miata-bot/daveecu2/pnps/Mazda/miata_89-93/miata_89-93.kicad_pcb

## KiCad design pnps/Mazda/miata_89-93/miata_89-93.kicad_pcb (2021-05-07)

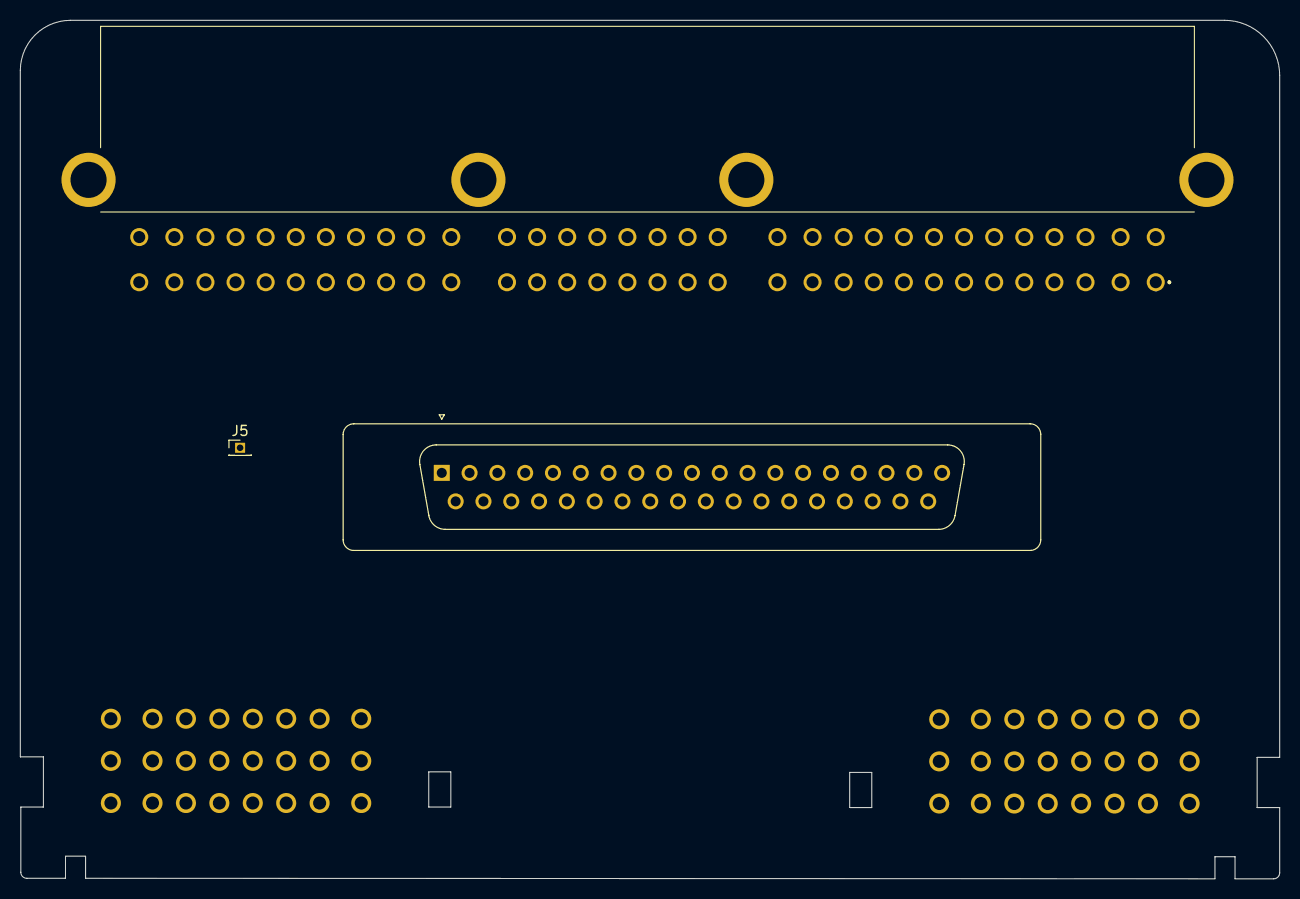
[picture p2: board miata_89-93.kicad_pcb from above]

Board: 2 copper layers, 125.5 x 85.5 mm, 5 parts (0 on the bottom side), 24 nets.

Parts:
J1: 174518-7
J2: Conn_01x37; DSUB-37_Male_Vertical_P2.77x2.84mm
J3: CONN_BLACK; Delphi_Sicma_24_Black
J4: CONN_GRAY; Delphi_Sicma_24_Grey
J5: 2ND TRIGGER; PinHeader_1x01_P1.27mm_Vertical

Connections:
GND: J1.MH1, J1.MH2, J1.MH3, J1.MH4, J3.A1, J3.A3, J3.A4, J3.A5, J3.B1, J3.B2, J3.B3, J3.B4, J4.C1, J4.C2
MIATA_1B: J1.16, J2.28
MIATA_1E: J1.56, J4.B4
MIATA_1G: J1.55, J3.C1
MIATA_1H: J1.63, J3.C3
MIATA_1N: J1.52, J1.60, J2.26, J3.A7
MIATA_1Q: J1.50, J4.A1
MIATA_1R: J1.58, J4.C4
MIATA_1V: J1.12, J4.A2
MIATA_2A: J1.8, J2.8, J2.9
MIATA_2C: J1.7, J2.1
MIATA_2D: J1.9, J2.2
MIATA_2E: J1.24, J2.24, J4.A8
MIATA_2G: J1.23, J4.A7, J5.1
MIATA_2I: J1.22, J4.C5
MIATA_2K: J1.21, J4.B8
MIATA_2L: J1.29, J2.22, J4.A3
MIATA_2N: J1.28, J2.23
MIATA_2O: J1.19, J2.37, J4.C3
MIATA_2P: J1.27, J2.20, J4.A4
MIATA_2Q: J1.18, J2.21, J4.A5
MIATA_2U: J1.3, J3.C7
MIATA_2V: J1.6, J3.C5
MIATA_2W: J1.2, J4.B7
