miata-bot/daveecu2/daveecu2.kicad_pcb

## KiCad design daveecu2.kicad_pcb (2021-05-07)

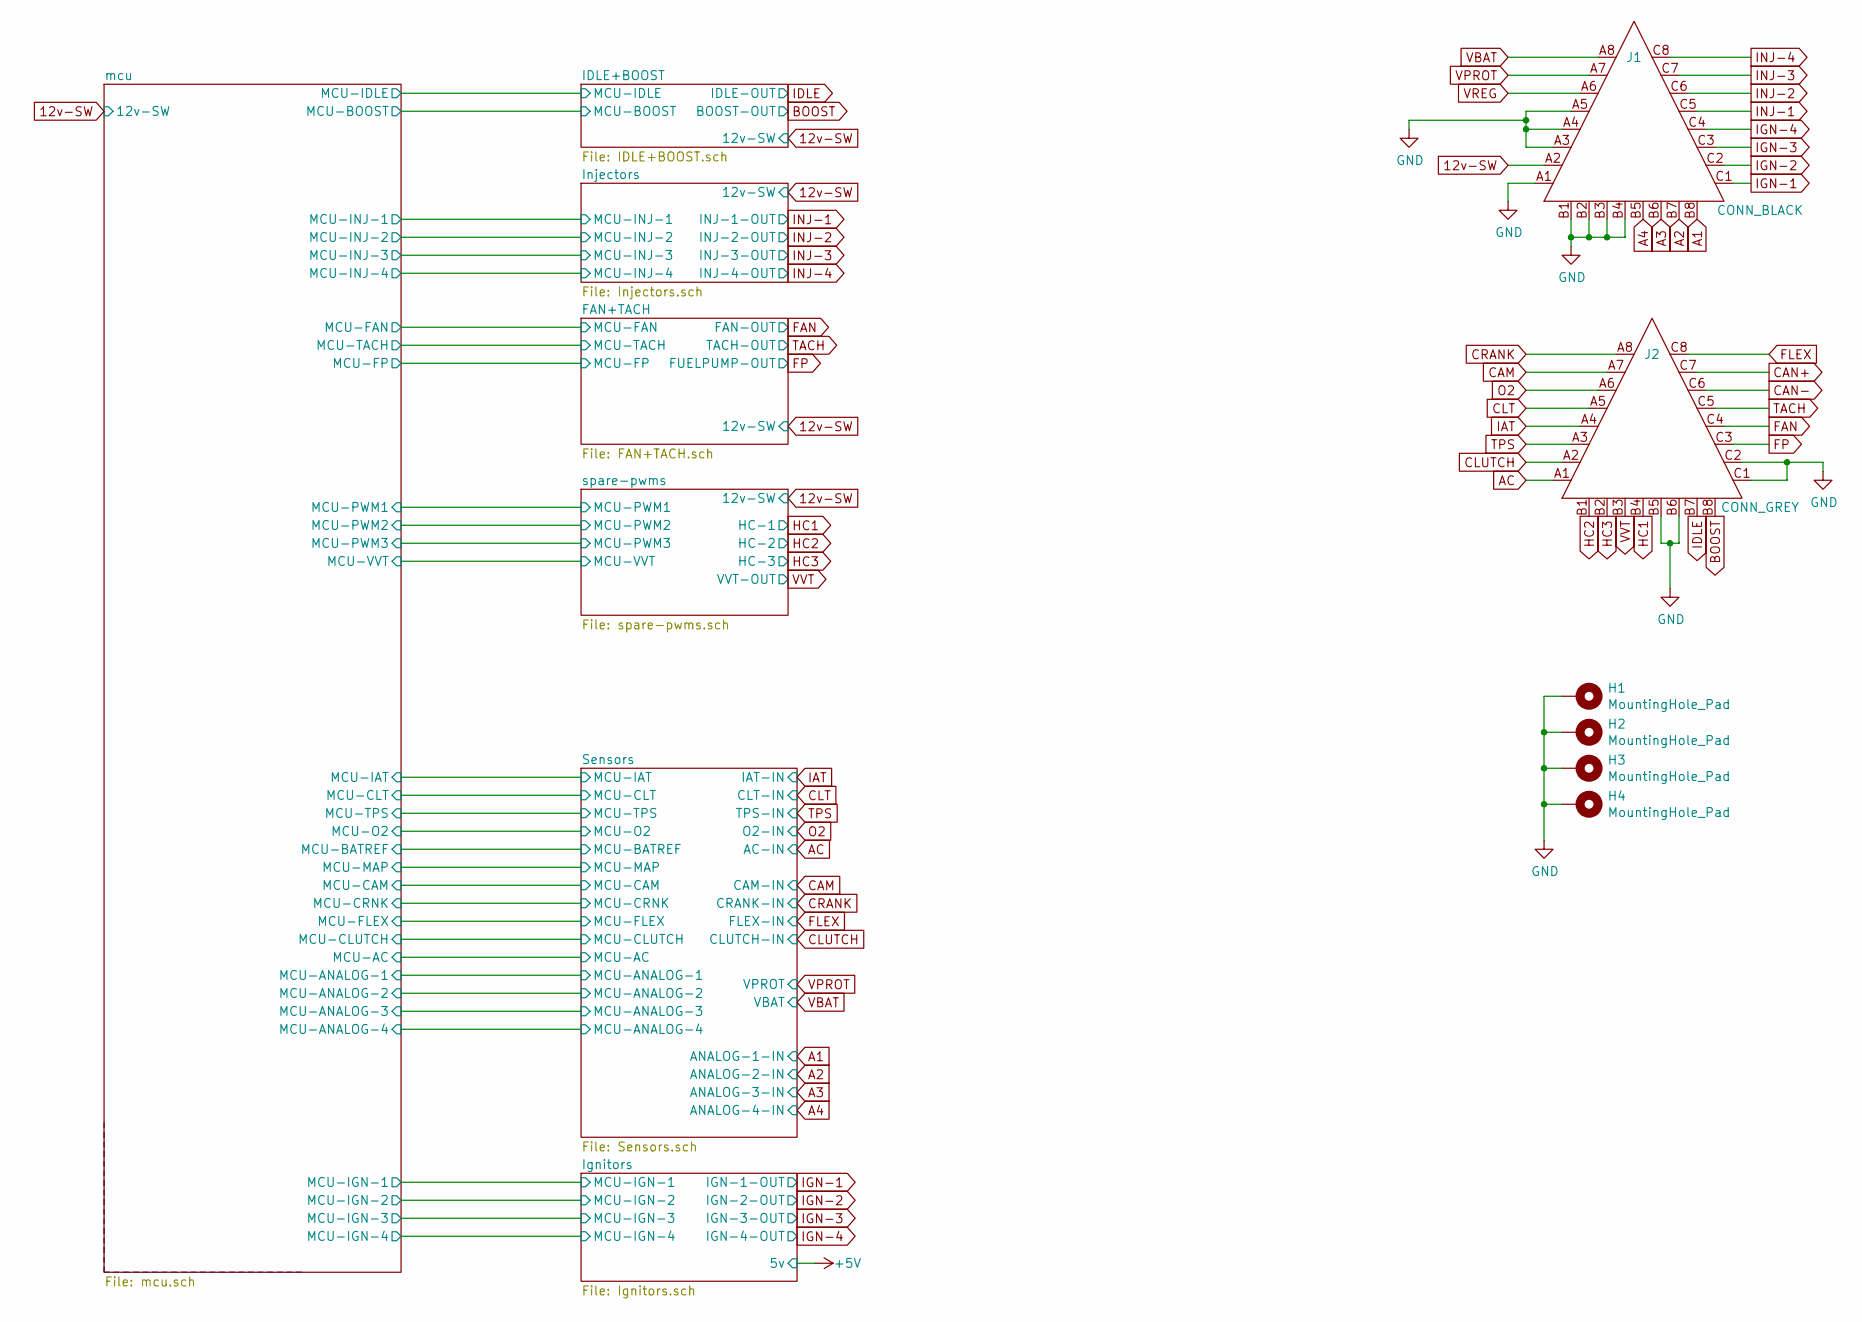
[picture p3: schematic daveecu2.sch]

Parts:
H1, H2, H3, H4: MountingHole_Pad; MountingHole_4.3mm_M4_Pad_Via
J1: CONN_BLACK; Delphi_Sicma_24_Black
J2: CONN_GREY; Delphi_Sicma_24_Grey

Connections:
12v-SW: J1.A2; also elsewhere on the board
A1: J1.B8; also elsewhere on the board
A2: J1.B7; also elsewhere on the board
A3: J1.B6; also elsewhere on the board
A4: J1.B5; also elsewhere on the board
AC: J2.A1; also elsewhere on the board
ADC-CLAMP-7: J2.C8; also elsewhere on the board
BOOST: J2.B8; also elsewhere on the board
CAM: J2.A7; also elsewhere on the board
CAN+: J2.C7; also elsewhere on the board
CAN-: J2.C6; also elsewhere on the board
CLT: J2.A5; also elsewhere on the board
CLUTCH: J2.A2; also elsewhere on the board
CRANK: J2.A8; also elsewhere on the board
FAN: J2.C4; also elsewhere on the board
FP: J2.C3; also elsewhere on the board
GND: H1.1, H2.1, H3.1, H4.1, J1.A1, J1.A3, J1.A4, J1.A5, J1.B1, J1.B2, J1.B3, J1.B4, J2.B5, J2.B6, J2.C1, J2.C2; also elsewhere on the board
HC1: J2.B4; also elsewhere on the board
HC2: J2.B1; also elsewhere on the board
HC3: J2.B2; also elsewhere on the board
IAT: J2.A4; also elsewhere on the board
IDLE: J2.B7; also elsewhere on the board
IGN-1: J1.C1; also elsewhere on the board
IGN-2: J1.C2; also elsewhere on the board
IGN-3: J1.C3; also elsewhere on the board
IGN-4: J1.C4; also elsewhere on the board
INJ-1: J1.C5; also elsewhere on the board
INJ-2: J1.C6; also elsewhere on the board
INJ-3: J1.C7; also elsewhere on the board
INJ-4: J1.C8; also elsewhere on the board
O2: J2.A6; also elsewhere on the board
TACH: J2.C5; also elsewhere on the board
TPS: J2.A3; also elsewhere on the board
VBAT: J1.A8; also elsewhere on the board
VPROT: J1.A7; also elsewhere on the board
VREG: J1.A6; also elsewhere on the board
VVT: J2.B3; also elsewhere on the board

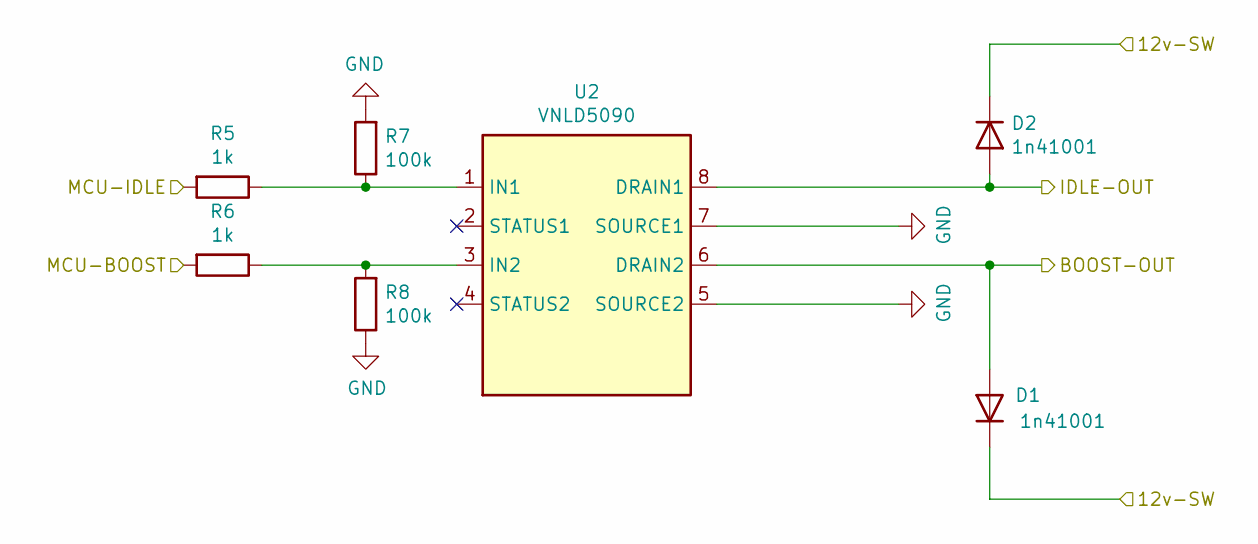
[picture p4: schematic IDLE+BOOST.sch, DaveECU2]

Parts:
D1, D2: 1n41001; D_SOD-123; LCSC_PN C162732
R5, R6: 1k; R_0603_1608Metric_Pad0.98x0.95mm_HandSolder; DIGIKEY 311-1.00KCRCT-ND
R7, R8: 100k; R_0603_1608Metric_Pad0.98x0.95mm_HandSolder; DIGIKEY 311-100KCRCT-ND
U2: VNLD5090; SOIC-8_3.9x4.9mm_P1.27mm

Connections:
12v-SW: D1.1 (K), D2.1 (K); also elsewhere on the board
/IDLE+BOOST/MCU-BOOST: R6.2; also elsewhere on the board
/IDLE+BOOST/MCU-IDLE: R5.2; also elsewhere on the board
BOOST: D1.2 (A), U2.6 (DRAIN2); also elsewhere on the board
GND: R7.2, R8.1, U2.5 (SOURCE2), U2.7 (SOURCE1); also elsewhere on the board
IDLE: D2.2 (A), U2.8 (DRAIN1); also elsewhere on the board
unnamed: R5.1, R7.1, U2.1 (IN1)
unnamed: R6.1, R8.2, U2.3 (IN2)

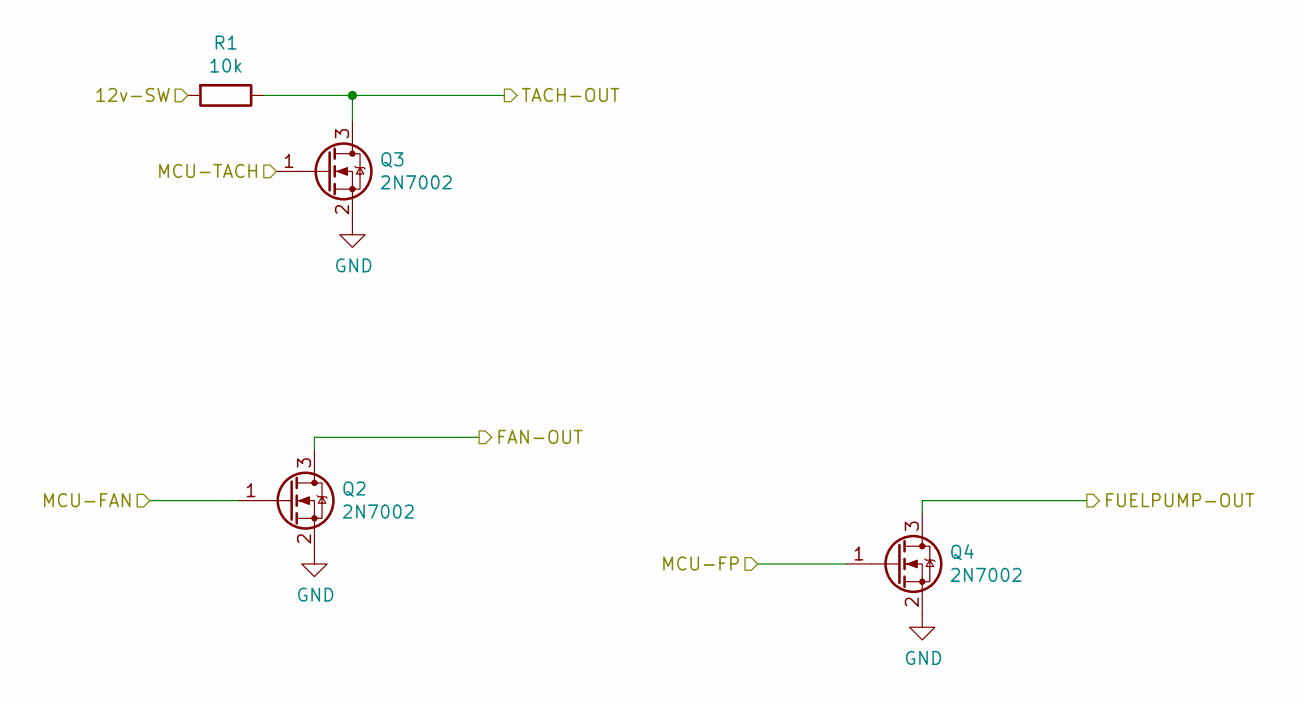
[picture p5: schematic FAN+TACH.sch, DaveECU2]

Parts:
Q2, Q3, Q4: 2N7002; SOT-23
R1: 10k; R_0603_1608Metric_Pad0.98x0.95mm_HandSolder; DIGIKEY 311-1.00KCRCT-ND

Connections:
12v-SW: R1.2; also elsewhere on the board
/FAN+TACH/MCU-FAN: Q2.1 (G); also elsewhere on the board
/FAN+TACH/MCU-FP: Q4.1 (G); also elsewhere on the board
/FAN+TACH/MCU-TACH: Q3.1 (G); also elsewhere on the board
FAN: Q2.3 (D); also elsewhere on the board
FP: Q4.3 (D); also elsewhere on the board
GND: Q2.2 (S), Q3.2 (S), Q4.2 (S); also elsewhere on the board
TACH: Q3.3 (D), R1.1; also elsewhere on the board

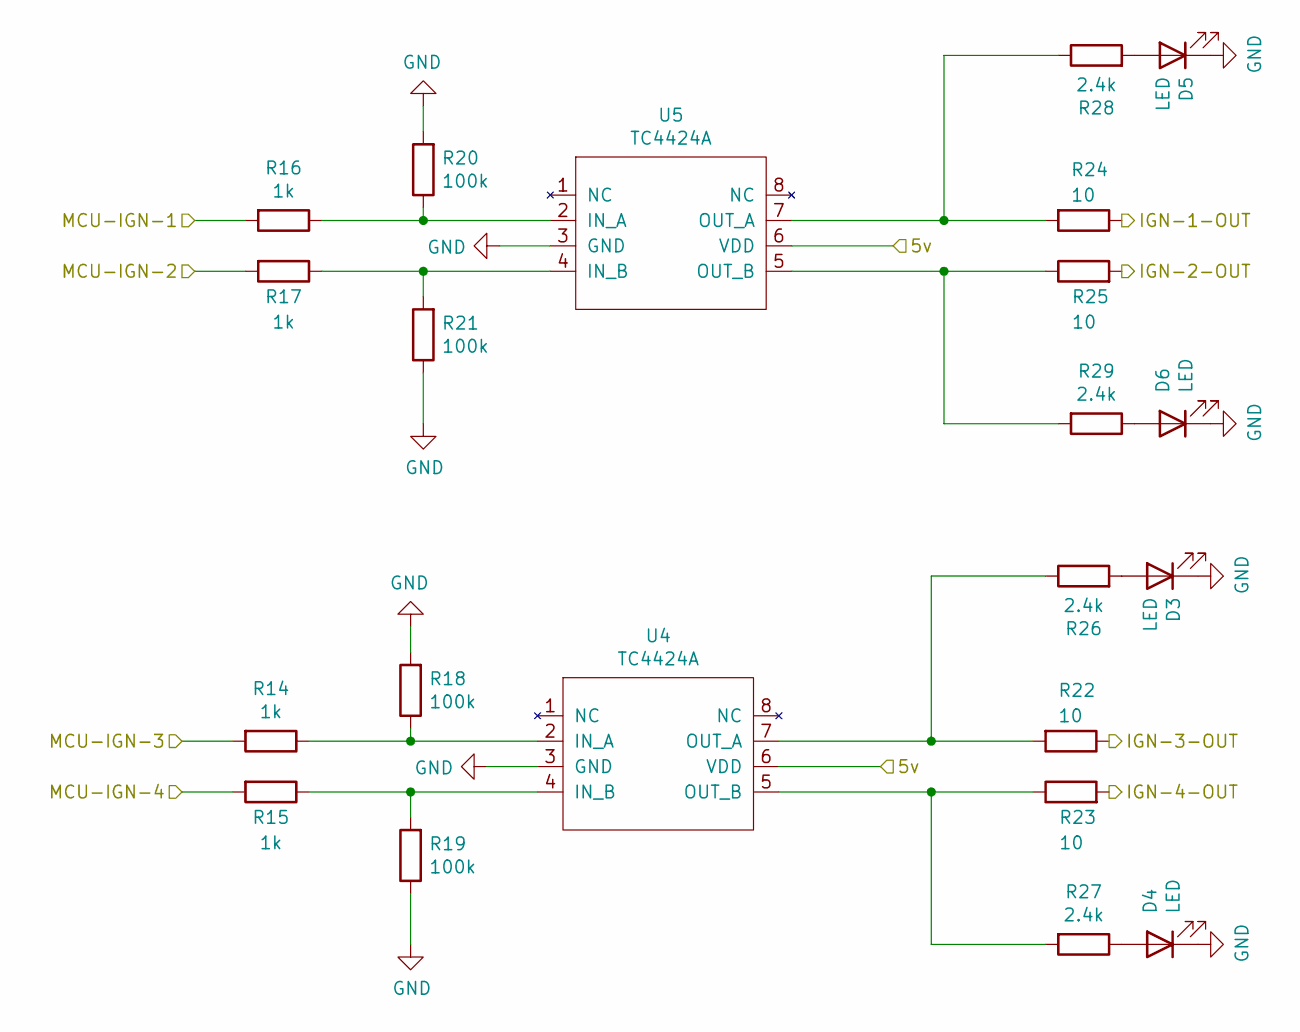
[picture p6: schematic Ignitors.sch, DaveECU2]

Parts:
D3, D4, D5, D6: LED; LED_0603_1608Metric_Pad1.05x0.95mm_HandSolder
R14, R15, R16, R17: 1k; R_0603_1608Metric_Pad0.98x0.95mm_HandSolder; DIGIKEY 311-1.00KCRCT-ND
R18, R19, R20, R21: 100k; R_0603_1608Metric_Pad0.98x0.95mm_HandSolder; DIGIKEY 311-100KCRCT-ND
R22, R23, R24, R25: 10; R_0603_1608Metric_Pad0.98x0.95mm_HandSolder; DIGIKEY 311-10.0CRCT-ND
R26, R27, R28, R29: 2.4k; R_0603_1608Metric_Pad0.98x0.95mm_HandSolder; DIGIKEY 311-2.40KCRCT-ND
U4, U5: TC4424A; SOIC-8_3.9x4.9mm_P1.27mm; DIGIKEY TC4424AVOA-ND

Connections:
/Ignitors/MCU-IGN-1: R16.2; also elsewhere on the board
/Ignitors/MCU-IGN-2: R17.2; also elsewhere on the board
/Ignitors/MCU-IGN-3: R14.2; also elsewhere on the board
/Ignitors/MCU-IGN-4: R15.2; also elsewhere on the board
GND: D3.1 (K), D4.1 (K), D5.1 (K), D6.1 (K), R18.2, R19.1, R20.2, R21.1, U4.3 (GND), U5.3 (GND); also elsewhere on the board
IGN-1: R24.1; also elsewhere on the board
IGN-2: R25.2; also elsewhere on the board
IGN-3: R22.1; also elsewhere on the board
IGN-4: R23.2; also elsewhere on the board
unnamed: D3.2 (A), R26.2
unnamed: D4.2 (A), R27.1
unnamed: D5.2 (A), R28.2
unnamed: D6.2 (A), R29.1
unnamed: R14.1, R18.1, U4.2 (IN_A)
unnamed: R15.1, R19.2, U4.4 (IN_B)
unnamed: R16.1, R20.1, U5.2 (IN_A)
unnamed: R17.1, R21.2, U5.4 (IN_B)
unnamed: R22.2, R26.1, U4.7 (OUT_A)
unnamed: R23.1, R27.2, U4.5 (OUT_B)
unnamed: R24.2, R28.1, U5.7 (OUT_A)
unnamed: R25.1, R29.2, U5.5 (OUT_B)
VPROT: U4.6 (VDD), U5.6 (VDD); also elsewhere on the board

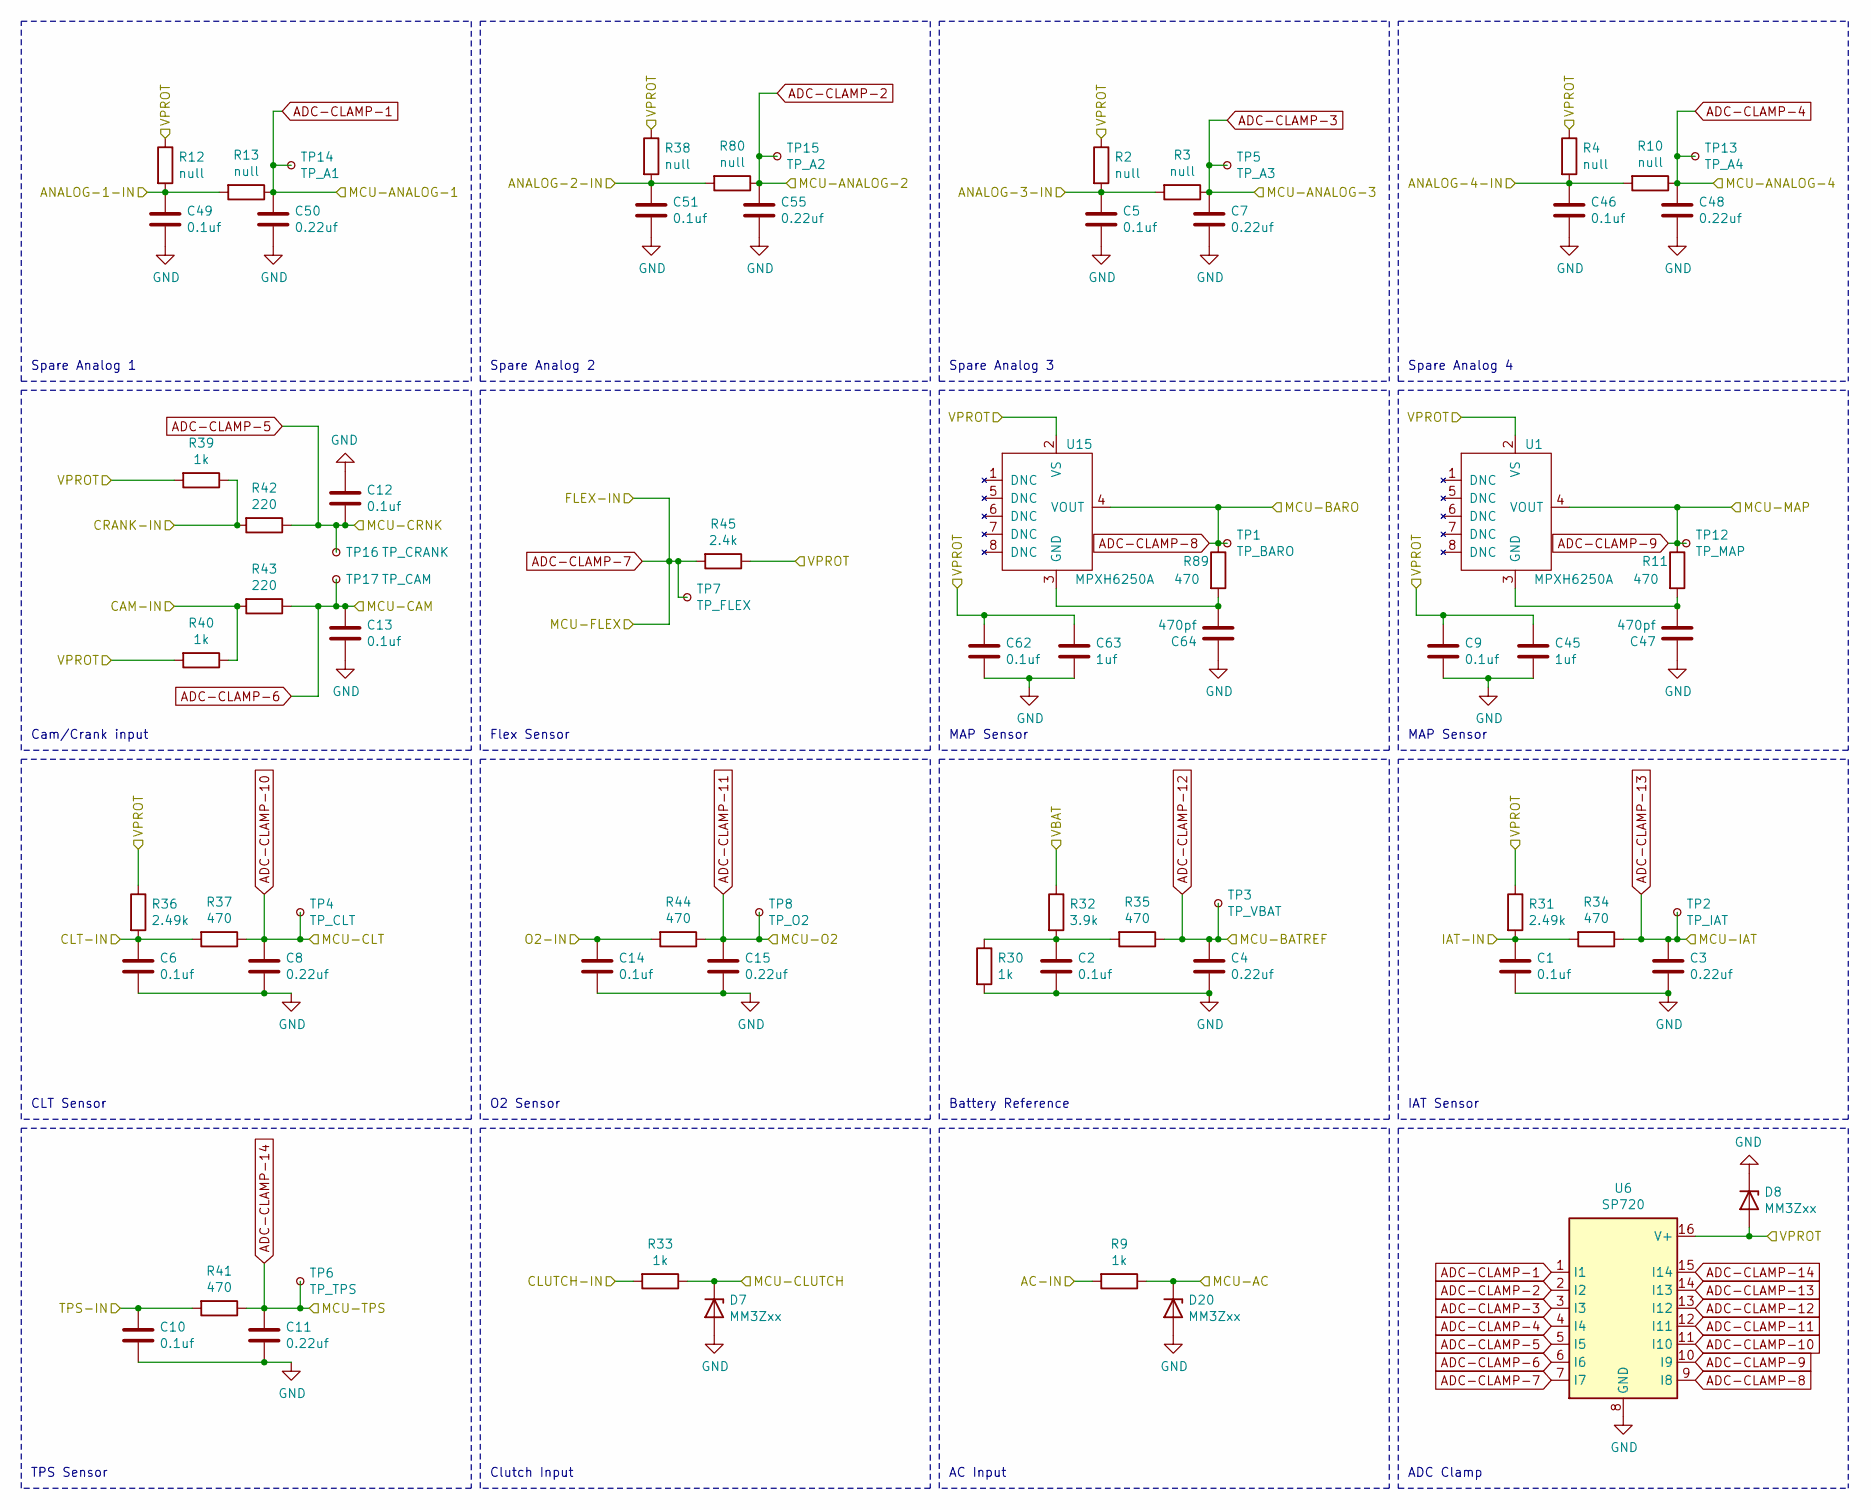
[picture p7: schematic Sensors.sch, DaveECU2]

Parts:
C1, C2, C5, C6, C9, C10, C12, C13, C14, C46, C49, C51, C62: 0.1uf; C_0805_2012Metric_Pad1.18x1.45mm_HandSolder; DIGIKEY 311-1140-1-ND
C3, C4, C7, C8, C11, C15, C48, C50, C55: 0.22uf; C_0805_2012Metric_Pad1.18x1.45mm_HandSolder; DIGIKEY 1276-1284-1-ND
C45, C63: 1uf; C_0805_2012Metric_Pad1.18x1.45mm_HandSolder; DIGIKEY 311-1365-1-ND
C47, C64: 470pf; C_0805_2012Metric_Pad1.18x1.45mm_HandSolder; DIGIKEY 311-1124-1-ND
D7, D8, D20: MM3Zxx; D_SOD-323_HandSoldering; DIGIKEY MM3Z5V1ST1GOSCT-ND
R2, R4, R12, R38: null; R_0805_2012Metric_Pad1.20x1.40mm_HandSolder; DIGIKEY YAG1854CT-ND
R3, R10, R13, R80: null; R_0805_2012Metric_Pad1.20x1.40mm_HandSolder; DIGIKEY P470CCT-ND
R9, R30, R33, R39, R40: 1k; R_0805_2012Metric_Pad1.20x1.40mm_HandSolder; DIGIKEY 311-1.00KCRCT-ND
R11, R34, R35, R37, R41, R44, R89: 470; R_0805_2012Metric_Pad1.20x1.40mm_HandSolder; DIGIKEY P470CCT-ND
R31, R36: 2.49k; R_0805_2012Metric_Pad1.20x1.40mm_HandSolder; DIGIKEY YAG1854CT-ND
R32: 3.9k; R_0805_2012Metric_Pad1.20x1.40mm_HandSolder; DIGIKEY 311-3.90KCRCT-ND
R42, R43: 220; R_0805_2012Metric_Pad1.20x1.40mm_HandSolder; DIGIKEY 311-220CRCT-ND
R45: 2.4k; R_0805_2012Metric_Pad1.20x1.40mm_HandSolder; DIGIKEY 311-2.40KCRCT-ND
TP1: TP_BARO; TestPoint_Pad_D1.0mm
TP2: TP_IAT; TestPoint_Pad_D1.0mm
TP3: TP_VBAT; TestPoint_Pad_D1.0mm
TP4: TP_CLT; TestPoint_Pad_D1.0mm
TP5: TP_A3; TestPoint_Pad_D1.0mm
TP6: TP_TPS; TestPoint_Pad_D1.0mm
TP7: TP_FLEX; TestPoint_Pad_D1.0mm
TP8: TP_O2; TestPoint_Pad_D1.0mm
TP12: TP_MAP; TestPoint_Pad_D1.0mm
TP13: TP_A4; TestPoint_Pad_D1.0mm
TP14: TP_A1; TestPoint_Pad_D1.0mm
TP15: TP_A2; TestPoint_Pad_D1.0mm
TP16: TP_CRANK; TestPoint_Pad_D1.0mm
TP17: TP_CAM; TestPoint_Pad_D1.0mm
U1, U15: MPXH6250A; Freescale_98ARH99066A
U6: SP720; SOIC-16_3.9x9.9mm_P1.27mm; DIGIKEY F3162CT-ND

Connections:
/Sensors/MCU-AC: D20.1 (K), R9.1; also elsewhere on the board
/Sensors/MCU-CLUTCH: D7.1 (K), R33.1; also elsewhere on the board
A1: C49.1, R12.2, R13.2; also elsewhere on the board
A2: C51.1, R38.2, R80.2; also elsewhere on the board
A3: C5.1, R2.2, R3.2; also elsewhere on the board
A4: C46.1, R4.2, R10.2; also elsewhere on the board
AC: R9.2; also elsewhere on the board
ADC-CLAMP-1: C50.1, R13.1, TP14.1, U6.1 (I1); also elsewhere on the board
ADC-CLAMP-2: C55.1, R80.1, TP15.1, U6.2 (I2); also elsewhere on the board
ADC-CLAMP-3: C7.1, R3.1, TP5.1, U6.3 (I3); also elsewhere on the board
ADC-CLAMP-4: C48.1, R10.1, TP13.1, U6.4 (I4); also elsewhere on the board
ADC-CLAMP-5: C12.2, R42.1, TP16.1, U6.5 (I5); also elsewhere on the board
ADC-CLAMP-6: C13.1, R43.1, TP17.1, U6.6 (I6); also elsewhere on the board
ADC-CLAMP-7: R45.2, TP7.1, U6.7 (I7); also elsewhere on the board
ADC-CLAMP-8: R89.1, TP1.1, U6.9 (I8), U15.4 (VOUT)
ADC-CLAMP-9: R11.1, TP12.1, U1.4 (VOUT), U6.10 (I9); also elsewhere on the board
ADC-CLAMP-10: C8.1, R37.1, TP4.1, U6.11 (I10); also elsewhere on the board
ADC-CLAMP-11: C15.1, R44.1, TP8.1, U6.12 (I11); also elsewhere on the board
ADC-CLAMP-12: C4.1, R35.1, TP3.1, U6.13 (I12); also elsewhere on the board
ADC-CLAMP-13: C3.1, R34.1, TP2.1, U6.14 (I13); also elsewhere on the board
ADC-CLAMP-14: C11.1, R41.1, TP6.1, U6.15 (I14); also elsewhere on the board
CAM: R40.1, R43.2; also elsewhere on the board
CLT: C6.1, R36.2, R37.2; also elsewhere on the board
CLUTCH: R33.2; also elsewhere on the board
CRANK: R39.1, R42.2; also elsewhere on the board
GND: C1.2, C2.2, C3.2, C4.2, C5.2, C6.2, C7.2, C8.2, C9.2, C10.2, C11.2, C12.1, C13.2, C14.2, C15.2, C45.2, C46.2, C47.1, C48.2, C49.2, C50.2, C51.2, C55.2, C62.2, C63.2, C64.1, D7.2 (A), D8.1 (K), D20.2 (A), R30.2, U6.8 (GND); also elsewhere on the board
IAT: C1.1, R31.2, R34.2; also elsewhere on the board
unnamed: C2.1, R30.1, R32.2, R35.2
unnamed: C47.2, R11.2, U1.3 (GND)
unnamed: C64.2, R89.2, U15.3 (GND)
O2: C14.1, R44.2; also elsewhere on the board
TPS: C10.1, R41.2; also elsewhere on the board
VBAT: R32.1; also elsewhere on the board
VPROT: C9.1, C45.1, C62.1, C63.1, D8.2 (A), R2.1, R4.1, R12.1, R31.1, R36.1, R38.1, R39.2, R40.2, R45.1, U1.2 (VS), U6.16 (V+), U15.2 (VS); also elsewhere on the board

Notes on the sheet:
IAT Sensor
CLT Sensor
TPS Sensor
O2 Sensor
Battery Reference
Cam/Crank input
Flex Sensor
Clutch Input
ADC Clamp
AC Input
Spare Analog 1
Spare Analog 2
Spare Analog 3
Spare Analog 4
MAP Sensor

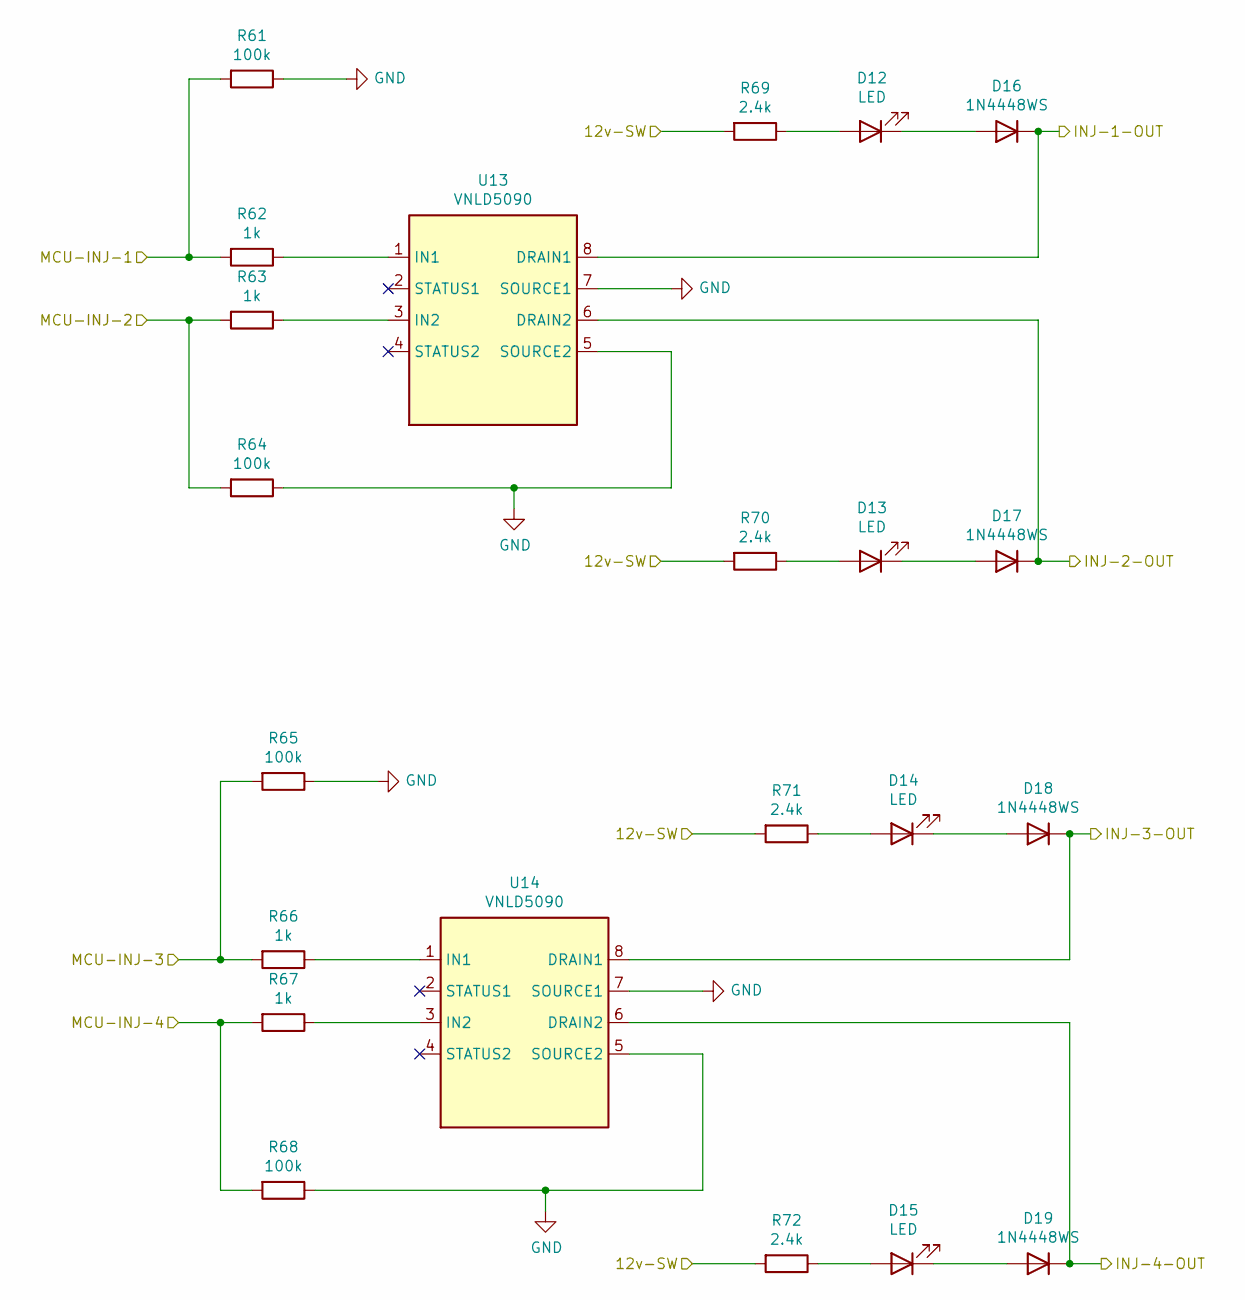
[picture p8: schematic Injectors.sch, DaveECU2]

Parts:
D12, D13, D14, D15: LED; LED_0603_1608Metric_Pad1.05x0.95mm_HandSolder; DIGIKEY 475-1415-1-ND
D16, D17, D18, D19: 1N4448WS; D_SOD-323_HandSoldering; DIGIKEY 1N4448WXTPMSCT-ND
R61, R64, R65, R68: 100k; R_0603_1608Metric_Pad0.98x0.95mm_HandSolder; DIGIKEY 311-100KCRCT-ND
R62, R63, R66, R67: 1k; R_0603_1608Metric_Pad0.98x0.95mm_HandSolder; DIGIKEY 311-1.00KCRCT-ND
R69, R70, R71, R72: 2.4k; R_0603_1608Metric_Pad0.98x0.95mm_HandSolder; DIGIKEY 311-2.40KCRCT-ND
U13, U14: VNLD5090; SOIC-8_3.9x4.9mm_P1.27mm; MOUSER 511-VNLD5090-E

Connections:
12v-SW: R69.2, R70.2, R71.2, R72.2; also elsewhere on the board
/Injectors/MCU-INJ-1: R61.2, R62.2; also elsewhere on the board
/Injectors/MCU-INJ-2: R63.2, R64.2; also elsewhere on the board
/Injectors/MCU-INJ-3: R65.2, R66.2; also elsewhere on the board
/Injectors/MCU-INJ-4: R67.2, R68.2; also elsewhere on the board
GND: R61.1, R64.1, R65.1, R68.1, U13.5 (SOURCE2), U13.7 (SOURCE1), U14.5 (SOURCE2), U14.7 (SOURCE1); also elsewhere on the board
INJ-1: D16.1 (K), U13.8 (DRAIN1); also elsewhere on the board
INJ-2: D17.1 (K), U13.6 (DRAIN2); also elsewhere on the board
INJ-3: D18.1 (K), U14.8 (DRAIN1); also elsewhere on the board
INJ-4: D19.1 (K), U14.6 (DRAIN2); also elsewhere on the board
unnamed: D12.1 (K), D16.2 (A)
unnamed: D12.2 (A), R69.1
unnamed: D13.1 (K), D17.2 (A)
unnamed: D13.2 (A), R70.1
unnamed: D14.1 (K), D18.2 (A)
unnamed: D14.2 (A), R71.1
unnamed: D15.1 (K), D19.2 (A)
unnamed: D15.2 (A), R72.1
unnamed: R62.1, U13.1 (IN1)
unnamed: R63.1, U13.3 (IN2)
unnamed: R66.1, U14.1 (IN1)
unnamed: R67.1, U14.3 (IN2)

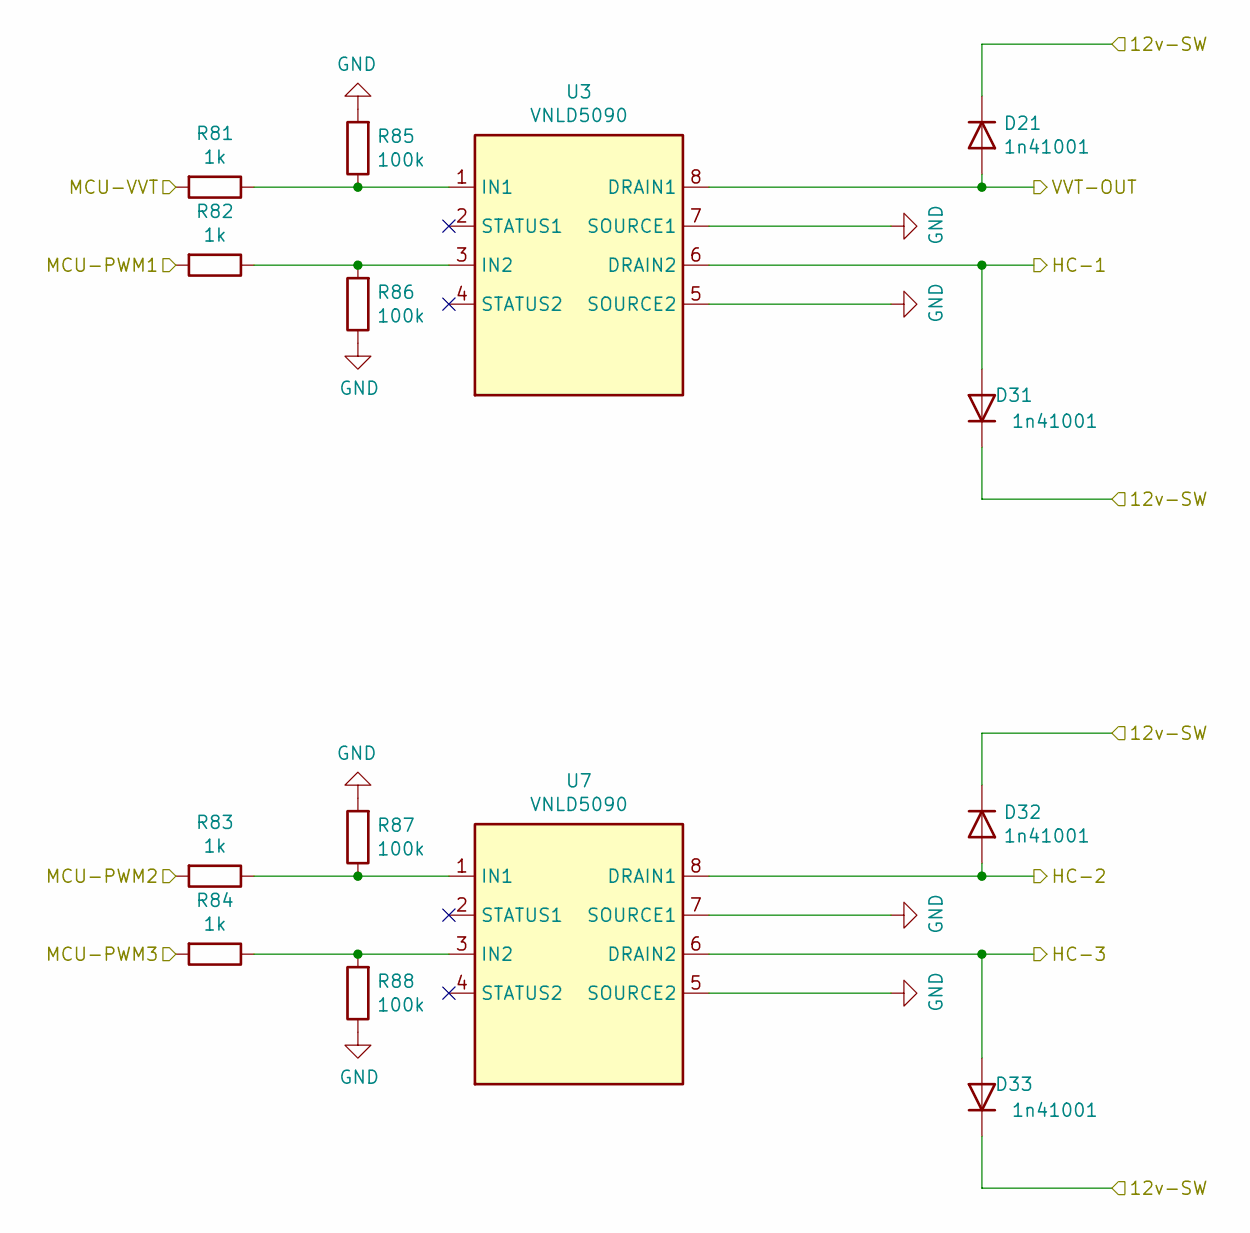
[picture p9: schematic spare-pwms.sch]

Parts:
D21, D31, D32, D33: 1n41001; D_SOD-123; LCSC_PN C162732
R81, R82, R83, R84: 1k; R_0603_1608Metric_Pad0.98x0.95mm_HandSolder; DIGIKEY 311-1.00KCRCT-ND
R85, R86, R87, R88: 100k; R_0603_1608Metric_Pad0.98x0.95mm_HandSolder; DIGIKEY 311-100KCRCT-ND
U3, U7: VNLD5090; SOIC-8_3.9x4.9mm_P1.27mm

Connections:
12v-SW: D21.1 (K), D31.1 (K), D32.1 (K), D33.1 (K); also elsewhere on the board
/mcu/MCU-PWM1: R82.2; also elsewhere on the board
/mcu/MCU-PWM2: R83.2; also elsewhere on the board
/mcu/MCU-PWM3: R84.2; also elsewhere on the board
/mcu/MCU-VVT: R81.2; also elsewhere on the board
GND: R85.2, R86.1, R87.2, R88.1, U3.5 (SOURCE2), U3.7 (SOURCE1), U7.5 (SOURCE2), U7.7 (SOURCE1); also elsewhere on the board
HC1: D31.2 (A), U3.6 (DRAIN2); also elsewhere on the board
HC2: D32.2 (A), U7.8 (DRAIN1); also elsewhere on the board
HC3: D33.2 (A), U7.6 (DRAIN2); also elsewhere on the board
unnamed: R81.1, R85.1, U3.1 (IN1)
unnamed: R82.1, R86.2, U3.3 (IN2)
unnamed: R83.1, R87.1, U7.1 (IN1)
unnamed: R84.1, R88.2, U7.3 (IN2)
VVT: D21.2 (A), U3.8 (DRAIN1); also elsewhere on the board
