miata-bot/daveecu2/daveecu2.kicad_pcb

## KiCad design daveecu2.kicad_pcb (continued)

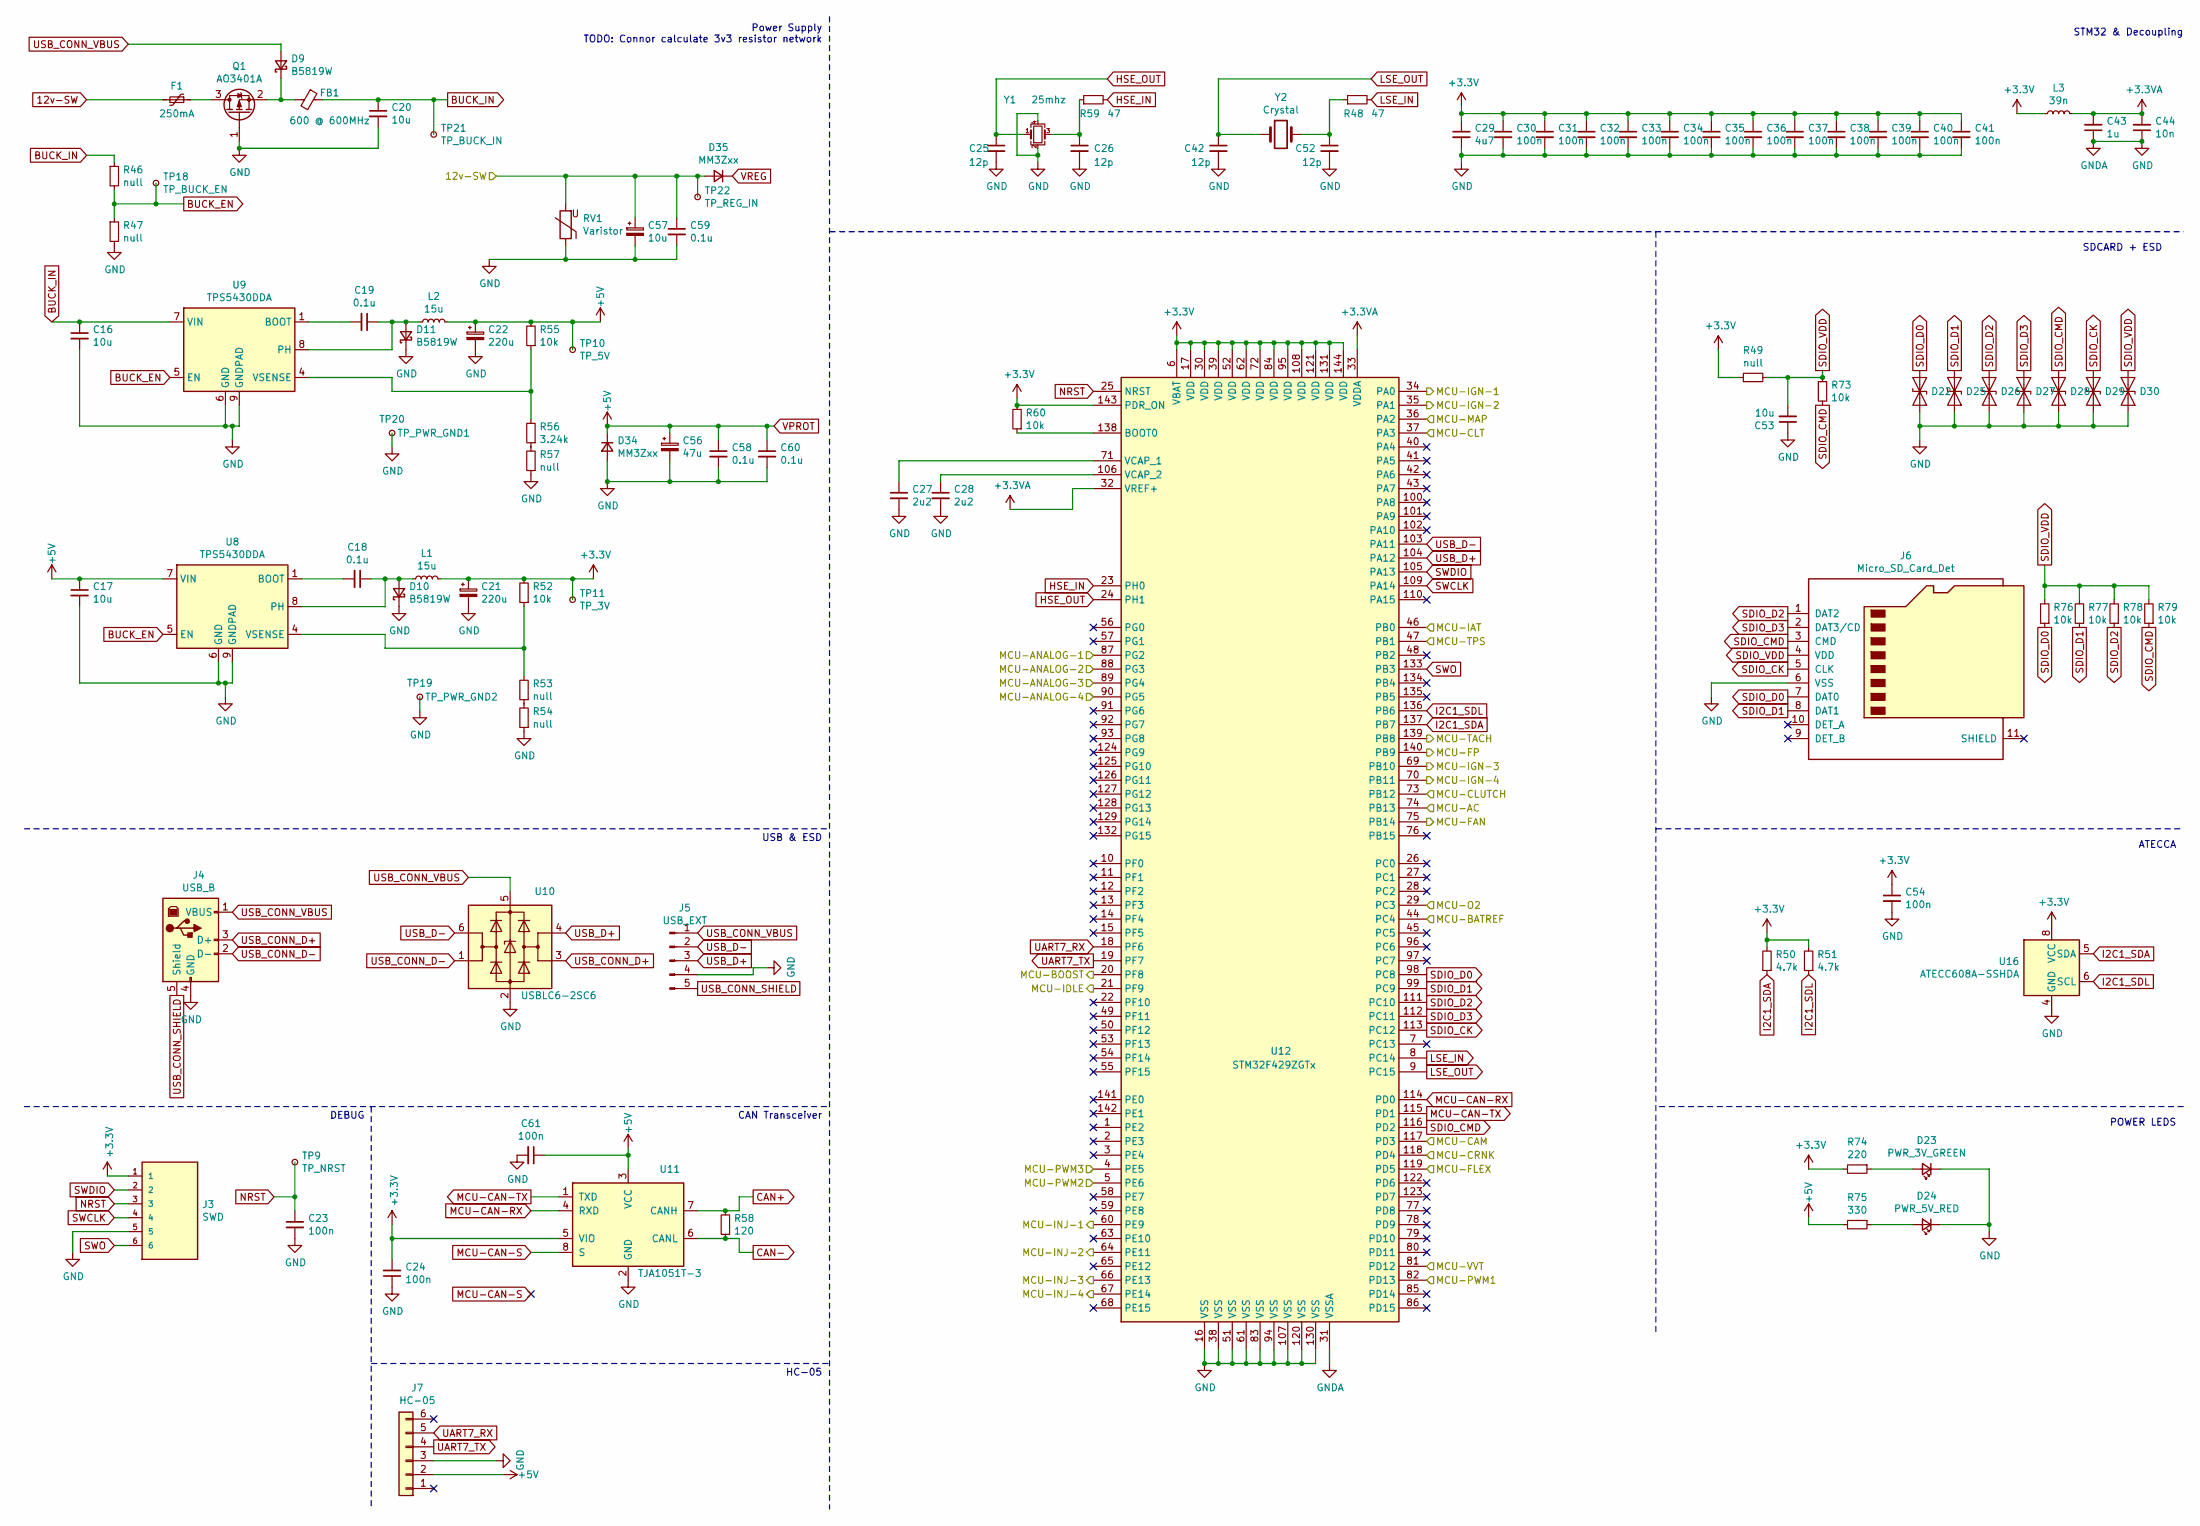
[picture p10: schematic mcu.sch, DaveECU2]

Parts:
C16, C17: 10u; C_1206_3216Metric_Pad1.33x1.80mm_HandSolder
C18, C19: 0.1u; C_0603_1608Metric_Pad1.08x0.95mm_HandSolder
C20: 10u; C_0603_1608Metric_Pad1.08x0.95mm_HandSolder
C21, C22: 220u; CP_Elec_10x14.3; LCSC_PN C401904
C23, C24, C30, C31, C32, C33, C34, C35, C36, C37, C38, C39, C40, C41, C54, C61: 100n; C_0402_1005Metric_Pad0.74x0.62mm_HandSolder
C25, C26, C42, C52: 12p; C_0402_1005Metric_Pad0.74x0.62mm_HandSolder
C27, C28: 2u2; C_0603_1608Metric_Pad1.08x0.95mm_HandSolder
C29: 4u7; C_0603_1608Metric_Pad1.08x0.95mm_HandSolder
C43: 1u; C_0402_1005Metric_Pad0.74x0.62mm_HandSolder
C44: 10n; C_0402_1005Metric_Pad0.74x0.62mm_HandSolder
C53: 10u; C_0402_1005Metric_Pad0.74x0.62mm_HandSolder
C56: 47u; CP_Elec_5x5.8; LCSC_PN C336380
C57: 10u; CP_EIA-7343-20_Kemet-V_Pad2.25x2.55mm_HandSolder; LCSC_PN C117038
C58, C59, C60: 0.1u; C_1206_3216Metric_Pad1.33x1.80mm_HandSolder; LCSC_PN C141184
D9, D10, D11: B5819W; D_SOD-123; LCSC_PN C541627
D22, D25, D26, D27, D28, D29, D30: ESD9B3.3ST5G; D_SOD-923; LCSC_PN C96512
D23: PWR_3V_GREEN; LED_0603_1608Metric_Pad1.05x0.95mm_HandSolder; LCSC_PN C440518
D24: PWR_5V_RED; LED_0603_1608Metric_Pad1.05x0.95mm_HandSolder; LCSC_PN C192315
D34, D35: MM3Zxx; D_SOD-323_HandSoldering; LCSC_PN C152524
F1: 250mA; Fuse_1206_3216Metric_Pad1.42x1.75mm_HandSolder
FB1: 600 @ 600MHz; L_0805_2012Metric_Pad1.05x1.20mm_HandSolder
J3: SWD; TAG_TC2030-IDC-NL; PARTREV MS
J4: USB_B; USB_B_Lumberg_2411_02_Horizontal
J5: USB_EXT; PinHeader_1x05_P2.54mm_Vertical_SMD_Pin1Left
J6: Micro_SD_Card_Det; microSD_HC_Molex_104031-0811
J7: HC-05; PinHeader_1x06_P2.54mm_Vertical
L1, L2: 15u; L_Sunlord_MWSA0518_5.4x5.2mm; LCSC_PN C139506
L3: 39n; L_0402_1005Metric_Pad0.77x0.64mm_HandSolder
Q1: AO3401A; SOT-23
R46, R47, R49, R53, R54, R57: null; R_0603_1608Metric_Pad0.98x0.95mm_HandSolder
R48, R59: 47; R_0402_1005Metric_Pad0.72x0.64mm_HandSolder
R50, R51: 4.7k; R_0603_1608Metric_Pad0.98x0.95mm_HandSolder
R52, R55, R73, R76, R77, R78, R79: 10k; R_0603_1608Metric_Pad0.98x0.95mm_HandSolder
R56: 3.24k; R_0603_1608Metric_Pad0.98x0.95mm_HandSolder
R58: 120; R_0603_1608Metric_Pad0.98x0.95mm_HandSolder
R60: 10k; R_0402_1005Metric_Pad0.72x0.64mm_HandSolder
R74: 220; R_0603_1608Metric_Pad0.98x0.95mm_HandSolder
R75: 330; R_0603_1608Metric_Pad0.98x0.95mm_HandSolder
RV1: Varistor; RV_Disc_D15.5mm_W3.9mm_P7.5mm; LCSC_PN C1527916
TP9: TP_NRST; TestPoint_Pad_D1.0mm
TP10: TP_5V; TestPoint_Pad_D1.0mm
TP11: TP_3V; TestPoint_Pad_D1.0mm
TP18: TP_BUCK_EN; TestPoint_Pad_D1.0mm
TP19: TP_PWR_GND2; TestPoint_Pad_D1.0mm
TP20: TP_PWR_GND1; TestPoint_Pad_D1.0mm
TP21: TP_BUCK_IN; TestPoint_Pad_D1.0mm
TP22: TP_REG_IN; TestPoint_Pad_D1.0mm
U8, U9: TPS5430DDA; TI_SO-PowerPAD-8_ThermalVias
U10: USBLC6-2SC6; SOT-23-6
U11: TJA1051T-3; SOIC-8_3.9x4.9mm_P1.27mm
U12: STM32F429ZGTx; LQFP-144_20x20mm_P0.5mm
U16: ATECC608A-SSHDA; SOIC-8_3.9x4.9mm_P1.27mm; LCSC_PN C2650407
Y1: 25mhz; Crystal_SMD_3225-4Pin_3.2x2.5mm_HandSoldering; LCSC_PN C439049
Y2: Crystal; Crystal_SMD_3215-2Pin_3.2x1.5mm; LCSC_PN C97604

Connections:
12v-SW: C57.1, C59.1, D35.2 (A), F1.2, RV1.2, TP22.1; also elsewhere on the board
+3.3VA: C43.2, C44.2, L3.2, U12.32 (VREF+), U12.33 (VDDA)
+3V3: C21.1, C24.2, C29.1, C30.1, C31.1, C32.1, C33.1, C34.1, C35.1, C36.1, C37.1, C38.1, C39.1, C40.1, C41.1, C54.1, J3.1, L1.2, L3.1, R49.1, R50.2, R51.2, R52.2, R60.2, R74.2, TP11.1, U11.5 (VIO), U12.6 (VBAT), U12.17 (VDD), U12.30 (VDD), U12.39 (VDD), U12.52 (VDD), U12.62 (VDD), U12.72 (VDD), U12.84 (VDD), U12.95 (VDD), U12.108 (VDD), U12.121 (VDD), U12.131 (VDD), U12.143 (PDR_ON), U12.144 (VDD), U16.8 (VCC)
/FAN+TACH/MCU-FAN: U12.75 (PB14); also elsewhere on the board
/FAN+TACH/MCU-FP: U12.140 (PB9); also elsewhere on the board
/FAN+TACH/MCU-TACH: U12.139 (PB8); also elsewhere on the board
/IDLE+BOOST/MCU-BOOST: U12.20 (PF8); also elsewhere on the board
/IDLE+BOOST/MCU-IDLE: U12.21 (PF9); also elsewhere on the board
/Ignitors/MCU-IGN-1: U12.34 (PA0); also elsewhere on the board
/Ignitors/MCU-IGN-2: U12.35 (PA1); also elsewhere on the board
/Ignitors/MCU-IGN-3: U12.69 (PB10); also elsewhere on the board
/Ignitors/MCU-IGN-4: U12.70 (PB11); also elsewhere on the board
/Injectors/MCU-INJ-1: U12.60 (PE9); also elsewhere on the board
/Injectors/MCU-INJ-2: U12.64 (PE11); also elsewhere on the board
/Injectors/MCU-INJ-3: U12.66 (PE13); also elsewhere on the board
/Injectors/MCU-INJ-4: U12.67 (PE14); also elsewhere on the board
/Sensors/MCU-AC: U12.74 (PB13); also elsewhere on the board
/Sensors/MCU-CLUTCH: U12.73 (PB12); also elsewhere on the board
/mcu/MCU-PWM1: U12.82 (PD13); also elsewhere on the board
/mcu/MCU-PWM2: U12.5 (PE6); also elsewhere on the board
/mcu/MCU-PWM3: U12.4 (PE5); also elsewhere on the board
/mcu/MCU-VVT: U12.81 (PD12); also elsewhere on the board
ADC-CLAMP-1: U12.87 (PG2); also elsewhere on the board
ADC-CLAMP-2: U12.88 (PG3); also elsewhere on the board
ADC-CLAMP-3: U12.89 (PG4); also elsewhere on the board
ADC-CLAMP-4: U12.90 (PG5); also elsewhere on the board
ADC-CLAMP-5: U12.118 (PD4); also elsewhere on the board
ADC-CLAMP-6: U12.117 (PD3); also elsewhere on the board
ADC-CLAMP-7: U12.119 (PD5); also elsewhere on the board
ADC-CLAMP-9: U12.36 (PA2); also elsewhere on the board
ADC-CLAMP-10: U12.37 (PA3); also elsewhere on the board
ADC-CLAMP-11: U12.29 (PC3); also elsewhere on the board
ADC-CLAMP-12: U12.44 (PC4); also elsewhere on the board
ADC-CLAMP-13: U12.46 (PB0); also elsewhere on the board
ADC-CLAMP-14: U12.47 (PB1); also elsewhere on the board
BUCK_EN: R46.2, R47.1, TP18.1, U8.5 (EN), U9.5 (EN)
BUCK_IN: C16.1, C20.1, FB1.1, R46.1, TP21.1, U9.7 (VIN)
CAN+: R58.2, U11.7 (CANH); also elsewhere on the board
CAN-: R58.1, U11.6 (CANL); also elsewhere on the board
GND: C16.2, C17.2, C20.2, C21.2, C22.2, C23.2, C24.1, C25.2, C26.2, C27.2, C28.2, C29.2, C30.2, C31.2, C32.2, C33.2, C34.2, C35.2, C36.2, C37.2, C38.2, C39.2, C40.2, C41.2, C42.2, C43.1, C44.1, C52.2, C53.1, C54.2, C56.2, C57.2, C58.2, C59.2, C60.2, C61.2, D10.1 (K), D11.1 (K), D22.2 (A2), D23.1 (K), D24.1 (K), D25.2 (A2), D26.2 (A2), D27.2 (A2), D28.2 (A2), D29.2 (A2), D30.2 (A2), D34.2 (A), J3.5, J4.4 (GND), J5.4, J6.6 (VSS), J7.3, Q1.1 (G), R47.2, R54.1, R57.1, RV1.1, TP19.1, TP20.1, U8.6 (GND), U8.9 (GNDPAD), U9.6 (GND), U9.9 (GNDPAD), U10.2 (GND), U11.2 (GND), U12.16 (VSS), U12.31 (VSSA), U12.38 (VSS), U12.51 (VSS), U12.61 (VSS), U12.83 (VSS), U12.94 (VSS), U12.107 (VSS), U12.120 (VSS), U12.130 (VSS), U16.4 (GND), Y1.2, Y1.4; also elsewhere on the board
HSE_IN: R59.2, U12.23 (PH0)
HSE_OUT: C25.1, U12.24 (PH1), Y1.1
I2C1_SDA: R50.1, U12.137 (PB7), U16.5 (SDA)
I2C1_SDL: R51.1, U12.136 (PB6), U16.6 (SCL)
LSE_IN: R48.2, U12.8 (PC14)
LSE_OUT: C42.1, U12.9 (PC15), Y2.1
MCU-CAN-RX: U11.4 (RXD), U12.114 (PD0)
MCU-CAN-TX: U11.1 (TXD), U12.115 (PD1)
NRST: C23.1, J3.3, TP9.1, U12.25 (NRST)
unnamed: C18.1, D10.2 (A), L1.1, U8.8 (PH)
unnamed: C18.2, U8.1 (BOOT)
unnamed: C19.1, D11.2 (A), L2.1, U9.8 (PH)
unnamed: C19.2, U9.1 (BOOT)
unnamed: C26.1, R59.1, Y1.3
unnamed: C27.1, U12.71 (VCAP_1)
unnamed: C28.1, U12.106 (VCAP_2)
unnamed: C52.1, R48.1, Y2.2
unnamed: D9.1 (K), FB1.2, Q1.2 (S)
unnamed: D23.2 (A), R74.1
unnamed: D24.2 (A), R75.1
unnamed: F1.1, Q1.3 (D)
unnamed: R52.1, R53.2, U8.4 (VSENSE)
unnamed: R53.1, R54.2
unnamed: R55.1, R56.2, U9.4 (VSENSE)
unnamed: R56.1, R57.2
unnamed: R60.1, U12.138 (BOOT0)
SDIO_CK: D29.1 (A1), J6.5 (CLK), U12.113 (PC12)
SDIO_CMD: D28.1 (A1), J6.3 (CMD), R73.2, R79.1, U12.116 (PD2)
SDIO_D0: D22.1 (A1), J6.7 (DAT0), R76.1, U12.98 (PC8)
SDIO_D1: D25.1 (A1), J6.8 (DAT1), R77.1, U12.99 (PC9)
SDIO_D2: D26.1 (A1), J6.1 (DAT2), R78.1, U12.111 (PC10)
SDIO_D3: D27.1 (A1), J6.2 (DAT3/CD), U12.112 (PC11)
SDIO_VDD: C53.2, D30.1 (A1), J6.4 (VDD), R49.2, R73.1, R76.2, R77.2, R78.2, R79.2
SWCLK: J3.4, U12.109 (PA14)
SWDIO: J3.2, U12.105 (PA13)
SWO: J3.6, U12.133 (PB3)
UART7_RX: J7.5, U12.18 (PF6)
UART7_TX: J7.4, U12.19 (PF7)
USB_CONN_D+: J4.3 (D+), U10.3 (I/O2)
USB_CONN_D-: J4.2 (D-), U10.1 (I/O1)
USB_CONN_SHIELD: J4.5 (Shield), J5.5
USB_CONN_VBUS: D9.2 (A), J4.1 (VBUS), J5.1, U10.5 (VBUS)
USB_D+: J5.3, U10.4 (I/O2), U12.104 (PA12)
USB_D-: J5.2, U10.6 (I/O1), U12.103 (PA11)
VPROT: C17.1, C22.1, C56.1, C58.1, C60.1, C61.1, D34.1 (K), J7.2, L2.2, R55.2, R75.2, TP10.1, U8.7 (VIN), U11.3 (VCC); also elsewhere on the board
VREG: D35.1 (K); also elsewhere on the board

Notes on the sheet:
Power Supply TODO: Connor calculate 3v3 resistor network
USB & ESD
DEBUG
STM32 & Decoupling
CAN Transceiver
SDCARD + ESD
ATECCA
POWER LEDS
HC-05

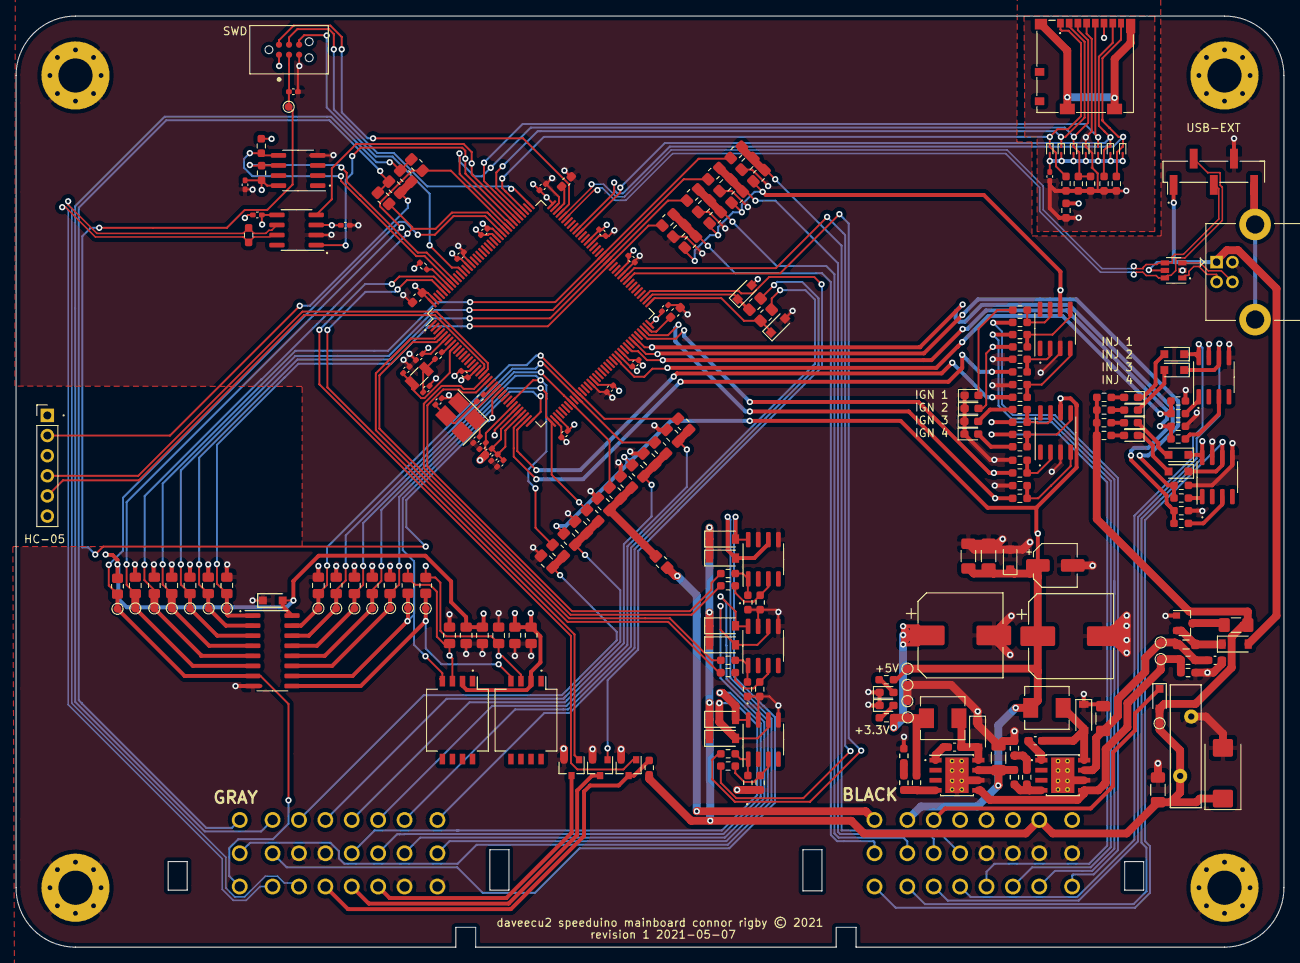
[picture p11: board daveecu2.kicad_pcb from above]

Board: 4 copper layers, 160.0 x 117.5 mm, 249 parts (0 on the bottom side), 150 nets.
