miata-bot/daveecu2/test-firmware/DaveECUTestFW.ioc

PD12.GPIO_Label=VVT
PG4.Signal=GPIO_Analog
PC12.Signal=SDIO_CK
PB14.GPIO_Label=FAN
PB13.Signal=GPIO_Input
PF7.Signal=UART7_TX
PD4.Signal=GPXTI4
PB6.Signal=I2C1_SCL
PH1/OSC_OUT.Signal=RCC_OSC_OUT
PC3.Signal=GPIO_Analog
PD0.Signal=CAN1_RX
PE5.Signal=S_TIM9_CH1
PB12.GPIO_Label=LAUNCH
PC4.GPIO_Label=BAT
PE9.Signal=S_TIM1_CH1
PB1.GPIO_Label=TPS
PA8.Signal=GPIO_Output
PB9.Signal=S_TIM4_CH4
PB1.Signal=ADCx_IN9
PD12.Signal=S_TIM4_CH1
PA10.Signal=GPIO_Output
PG5.Signal=GPIO_Analog
PA9.GPIO_Label=RN1
PD3.Signal=GPXTI3
PB11.GPIO_Label=IGN4
PD1.Signal=CAN1_TX
PF8.GPIO_Label=BOOST
PB8.GPIO_Label=TACH
PA8.GPIO_Label=CEL
PA9.Signal=GPIO_Output
PE9.GPIO_Label=INJ1
PB10.Signal=S_TIM2_CH3
PB14.Signal=SharedStack_PB14
PA5.Signal=SPI1_SCK
PE14.Signal=S_TIM1_CH4
PB15.GPIO_Label=VVT
PA1.GPIO_Label=IGN2
PA0/WKUP.GPIO_Label=IGN1
PA4.Signal=SPI1_NSS
PE13.GPIO_Label=INJ3
PA11.Signal=USB_OTG_FS_DM
PF9.Signal=S_TIM14_CH1
PC3.GPIO_Label=O2
PC15/OSC32_OUT.Signal=RCC_OSC32_OUT
PD2.Signal=SDIO_CMD
PB0.Signal=ADCx_IN8
Mcu.UserName=STM32F429ZGTx
PG2.Signal=GPIO_Analog
PE11.GPIO_Label=INJ2
PC10.Signal=SDIO_D2
PA0/WKUP.Signal=S_TIM2_CH1_ETR
PB0.GPIO_Label=IAT
PB13.GPIO_Label=AC
PB11.Signal=S_TIM2_CH4
PB15.Signal=S_TIM12_CH2
PD13.Signal=S_TIM4_CH2
PA12.Signal=USB_OTG_FS_DP
PE13.Signal=S_TIM1_CH3
PA10.GPIO_Label=RN2
PB7.Signal=I2C1_SDA
PA6.Signal=SPI1_MISO
PC14/OSC32_IN.Signal=RCC_OSC32_IN
PD5.GPIO_Label=FLEX
PA2.GPIO_Label=MAP
PF8.Signal=S_TIM13_CH1
PC5.Signal=GPIO_Analog
PD3.GPIO_Label=CAM
PA3.Signal=GPIO_Analog
PB9.GPIO_Label=FUELPUMP
PG3.Signal=GPIO_Analog
PC11.Signal=SDIO_D3
PC8.Signal=SDIO_D0
PC4.Signal=GPIO_Analog
PE14.GPIO_Label=INJ4
PD5.Signal=GPXTI5
PA13.Signal=SYS_JTMS-SWDIO
PF6.Signal=UART7_RX
PB10.GPIO_Label=IGN3
PF9.GPIO_Label=IDLE
PE11.Signal=S_TIM1_CH2
PA1.Signal=S_TIM2_CH2
PH0/OSC_IN.Signal=RCC_OSC_IN
PD4.GPIO_Label=CRANK
PE6.Signal=S_TIM9_CH2
PA2.Signal=GPIO_Analog
PB3.Signal=SYS_JTDO-SWO
PC5.GPIO_Label=BARO
PA14.Signal=SYS_JTCK-SWCLK
PB8.Signal=S_TIM4_CH3
PC9.Signal=SDIO_D1
PB12.Signal=GPIO_Input
PA3.GPIO_Label=CLT
PA7.Signal=SPI1_MOSI
