miata-bot/daveecu2/(commit log)

2020-06-18 Almost finished w/ schematic
    [FAN+TACH.sch, FuelPump.sch, IDLE+BOOST.sch, Ignitors.sch, Injectors.sch, Power+Reset.sch, Sensors.sch, mc33814.sch]
2020-06-21 Starting on layout
    [CONN.sch, FAN+TACH.sch, FuelPump.sch, IDLE+BOOST.sch, Ignitors.sch, Injectors.sch, Power+Reset.sch, Sensors.sch]
2021-04-21 restart a third time
    [CONN.sch, FAN+TACH.sch, FuelPump.sch, IDLE+BOOST.sch, Ignitors.sch, Injectors.sch, Power+Reset.sch, Sensors.sch]
2021-04-22 Layout p much finished.. Time for some stretch goals..?
    [mc33814.sch, mcu.sch, speeduino-aio-na6-pnp.kicad_pcb, speeduino-aio-na6-pnp.sch]
2021-04-22 rename project
    [daveecu2.kicad_pcb, daveecu2.sch]
2021-04-22 Update Schematic with a bunch of extra stuff
    [FAN+TACH.sch, FuelPump.sch, IDLE+BOOST.sch, Ignitors.sch, Injectors.sch, Sensors.sch, daveecu2.sch, mc33814.sch]
2021-04-23 Start rerouting again
    [FAN+TACH.sch, IDLE+BOOST.sch, Sensors.sch, daveecu2.kicad_pcb, mcu.sch, spare-pwms.sch]
2021-04-23 Layout checkpoint: everything fits on the board
    [IDLE+BOOST.sch, Ignitors.sch, Injectors.sch, Sensors.sch, daveecu2.kicad_pcb, mcu.sch]
2021-04-25 Finish reroute again
    [FAN+TACH.sch, Sensors.sch, daveecu2.kicad_pcb, daveecu2.sch, mcu.sch]
2021-04-28 Fixed LED names, added resistor values
    [mcu.sch]
2021-05-04 Reload netlist for new LED nets
    [daveecu2.kicad_pcb]
2021-05-04 Update README.md and board image
2021-05-07 Schematic and Layout Updates
    * cleanup unused pins for DRC
    * swap swd connector for the fancy one the phill uses
    * swap out the CAN transciever for one more suitable for 3v3
    * reroute CAN differential pair
    * clean up copper pours
    [IDLE+BOOST.sch, Sensors.sch, daveecu2.kicad_pcb, daveecu2.sch, mcu.sch, spare-pwms.sch]
2021-05-07 More routing updates
    * added stitching vias
    * organized sensor sheet
    * moved the CAN and Security chips closer together to clean up fills
    * added silkscreen text to some things
    [Sensors.sch, daveecu2.kicad_pcb]
2021-05-07 Start building PNP board for na6 miata
    [miata_89-93.kicad_pcb, miata_89-93.sch]
